TheBlackMini/upsy-desky/pcb_v2/upsy-desky.kicad_pcb

## KiCad design pcb_v2/upsy-desky.kicad_pcb (2024-06-04)

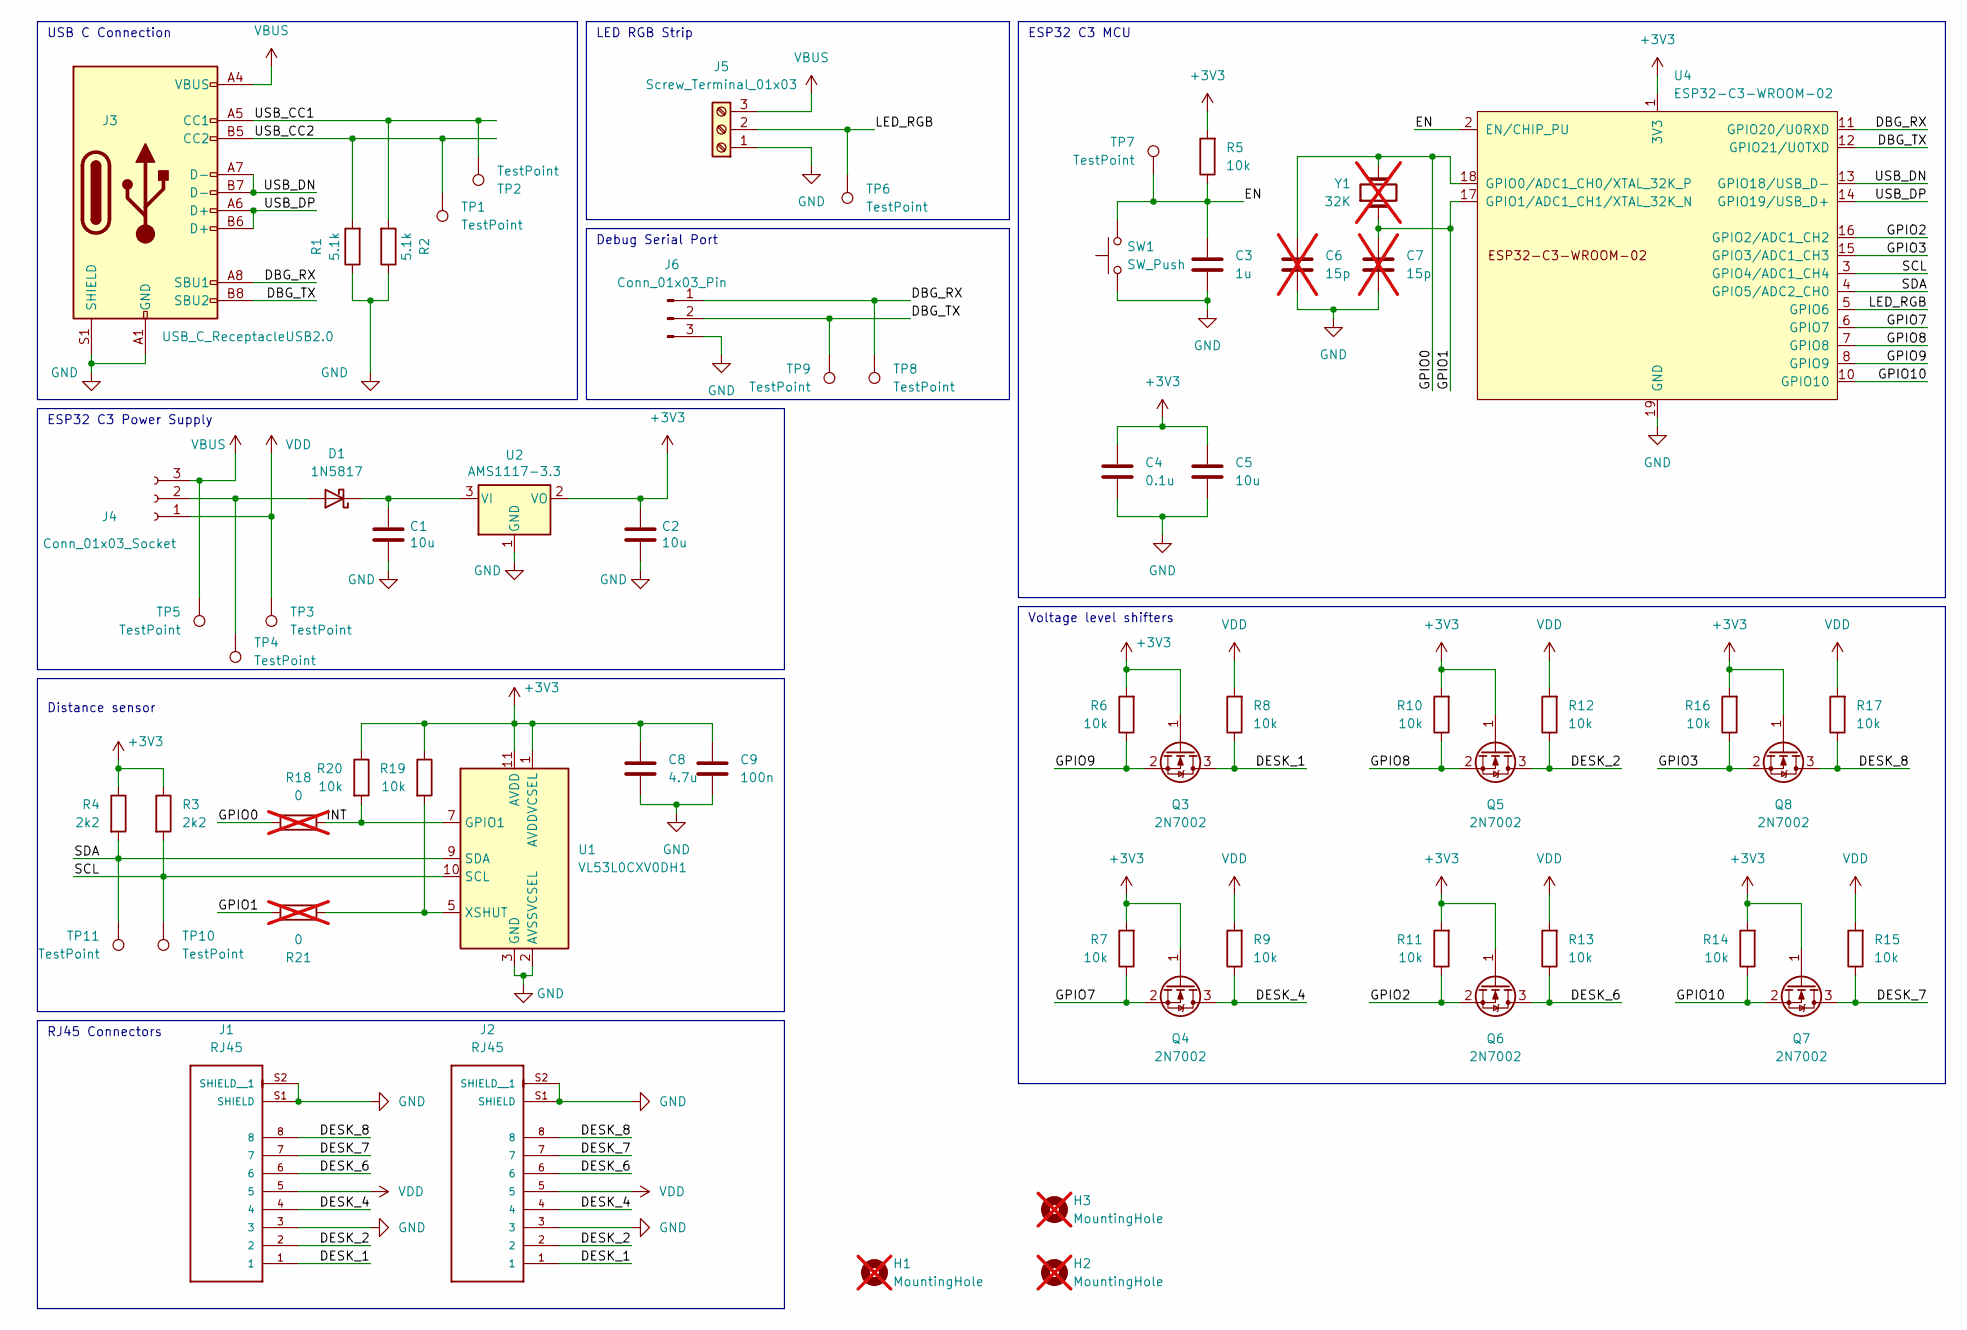
[picture p1: schematic upsy-desky.kicad_sch, (Risky) Upsy Desky]

Parts:
C1, C2, C5: 10u; C_0402_1005Metric; MPN GRM155R60J106ME05J; LCSC C15525
C3: 1u; C_0402_1005Metric; MPN 0402W105K100HI; LCSC C52923
C4: 0.1u; C_0402_1005Metric; MPN 0402B104K160HI; LCSC C1525
C6, C7: 15p; C_0402_1005Metric; MPN TCC0402COG150J500AT; not fitted
C8: 4.7u; C_0402_1005Metric; MPN CL05A475MQ5NRNC; DigiKey 1276-1056-2-ND
C9: 100n; C_0402_1005Metric; MPN CC0402KRX7R6BB104; DigiKey 311-1345-2-ND
D1: 1N5817; D_SOD-323; MPN B5817WS-TP; LCSC C191023
H1, H2, H3: MountingHole; MountingHole_2.2mm_M2_Pad; not fitted
J1, J2: RJ45; RJ45_Amphenol_54602-x08_Horizontal; PARTREV 00; LCSC C708595
J3: USB_C_ReceptacleUSB2.0; USB_C_Receptacle_Palconn_UTC16-G; MPN TYPE-C-31-M-12; LCSC C165948
J4: Conn_01x03_Socket; FanPinHeader_1x03_P2.54mm_Vertical; MPN 0022272031; DigiKey WM4112-ND
J5: Screw_Terminal_01x03; TerminalBlock_Altech_AK300-3_P5.00mm; MPN 30-003; DigiKey 1920-30.003-ND
J6: Conn_01x03_Pin; JST_EH_B3B-EH-A_1x03_P2.50mm_Vertical; MPN B3B-EH-A; DigiKey 455-B3B-EH-A-ND
Q3, Q4, Q5, Q6, Q7, Q8: 2N7002; SOT-23; MPN 2N7002; LCSC C8545
R1, R2: 5.1k; R_0402_1005Metric; MPN CR0402JC5K1S01; LCSC C25905
R3, R4: 2k2; R_0402_1005Metric; MPN RC0402FR-072K2L; DigiKey 311-2.20KLRTR-ND
R5, R6, R7, R8, R9, R10, R11, R12, R13, R14, R15, R16, R17: 10k; R_0402_1005Metric; MPN RC0402JR-1310KL; LCSC C25744
R18, R21: 0; R_0402_1005Metric; not fitted
R19, R20: 10k; R_0402_1005Metric; MPN RC0402JR-1310KL; DigiKey 13-RC0402JR-1310KLTR-ND
SW1: SW_Push; SW_Push_1P1T_NO_CK_KMR2; MPN KMR223GLFG; DigiKey 401-1428-2-ND
TP1, TP2, TP3, TP4, TP5, TP6, TP7, TP8, TP9, TP10, TP11: TestPoint; TestPoint_Pad_D1.0mm
U1: VL53L0CXV0DH1; ST_VL53L1x; MPN VL53L0CXV0DH/1; DigiKey 497-16538-2-ND
U2: AMS1117-3.3; SOT-223-3_TabPin2; MPN AMS1117-3.3; LCSC C6186
U4: ESP32-C3-WROOM-02; MPN ESP32-C3-WROOM-02-N4; DigiKey 1965-ESP32-C3-WROOM-02-N4TR-ND
Y1: 32K; Crystal_SMD_2012-2Pin_2.0x1.2mm; MPN 9HT11-32-768KDZF-T; DigiKey 887-1425-2-ND; not fitted

Connections:
+3V3: C2.1, C4.1, C5.1, C8.1, C9.1, Q3.1 (G), Q4.1 (G), Q5.1 (G), Q6.1 (G), Q7.1 (G), Q8.1 (G), R3.1, R4.1, R5.2, R6.2, R7.2, R10.2, R11.2, R14.2, R16.2, R19.1, R20.1, U1.1 (AVDDVCSEL), U1.11 (AVDD), U2.2 (VO), U4.1 (3V3)
/DBG_RX: J3.A8 (SBU1), J6.1, TP8.1, U4.11 (GPIO20/U0RXD)
/DBG_TX: J3.B8 (SBU2), J6.2, TP9.1, U4.12 (GPIO21/U0TXD)
/DESK_1: J1.1, J2.1, Q3.3 (D), R8.1
/DESK_2: J1.2, J2.2, Q5.3 (D), R12.1
/DESK_4: J1.4, J2.4, Q4.3 (D), R9.1
/DESK_6: J1.6, J2.6, Q6.3 (D), R13.1
/DESK_7: J1.7, J2.7, Q7.3 (D), R15.1
/DESK_8: J1.8, J2.8, Q8.3 (D), R17.1
/EN: C3.1, R5.1, SW1.2, TP7.1, U4.2 (EN/CHIP_PU)
/GPIO0: C6.1, R18.2, U4.18 (GPIO0/ADC1_CH0/XTAL_32K_P), Y1.2
/GPIO1: C7.1, R21.2, U4.17 (GPIO1/ADC1_CH1/XTAL_32K_N), Y1.1
/GPIO2: Q6.2 (S), R11.1, U4.16 (GPIO2/ADC1_CH2)
/GPIO3: Q8.2 (S), R16.1, U4.15 (GPIO3/ADC1_CH3)
/GPIO7: Q4.2 (S), R7.1, U4.6 (GPIO7)
/GPIO8: Q5.2 (S), R10.1, U4.7 (GPIO8)
/GPIO9: Q3.2 (S), R6.1, U4.8 (GPIO9)
/GPIO10: Q7.2 (S), R14.1, U4.10 (GPIO10)
/INT: R18.1, R20.2, U1.7 (GPIO1)
/LED_RGB: J5.2, TP6.1, U4.5 (GPIO6)
/SCL: R3.2, TP10.1, U1.10 (SCL), U4.3 (GPIO4/ADC1_CH4)
/SDA: R4.2, TP11.1, U1.9 (SDA), U4.4 (GPIO5/ADC2_CH0)
/USB_CC1: J3.A5 (CC1), R2.2, TP2.1
/USB_CC2: J3.B5 (CC2), R1.2, TP1.1
/USB_DN: J3.A7 (D-), J3.B7 (D-), U4.13 (GPIO18/USB_D-)
/USB_DP: J3.A6 (D+), J3.B6 (D+), U4.14 (GPIO19/USB_D+)
GND: C1.2, C2.2, C3.2, C4.2, C5.2, C6.2, C7.2, C8.2, C9.2, J1.3, J1.S1 (SHIELD), J1.S2 (SHIELD__1), J2.3, J2.S1 (SHIELD), J2.S2 (SHIELD__1), J3.A1 (GND), J3.A12 (GND), J3.B1 (GND), J3.B12 (GND), J3.S1 (SHIELD), J5.1, J6.3, R1.1, R2.1, SW1.1, U1.2 (AVSSVCSEL), U1.3 (GND), U1.4 (GND), U1.6 (GND), U1.12 (GND), U2.1 (GND), U4.9 (GND), U4.19 (GND)
unnamed: D1.2 (A), J4.2, TP4.1
unnamed: C1.1, D1.1 (K), U2.3 (VI)
unnamed: R19.2, R21.1, U1.5 (XSHUT)
VBUS: J3.A4 (VBUS), J3.A9 (VBUS), J3.B4 (VBUS), J3.B9 (VBUS), J4.3, J5.3, TP5.1
VDD: J1.5, J2.5, J4.1, R8.2, R9.2, R12.2, R13.2, R15.2, R17.2, TP3.1

Notes on the sheet:
ESP32 C3 MCU
Debug Serial Port
RJ45 Connectors
USB C Connection
LED RGB Strip
Distance sensor
Voltage level shifters
ESP32 C3 Power Supply

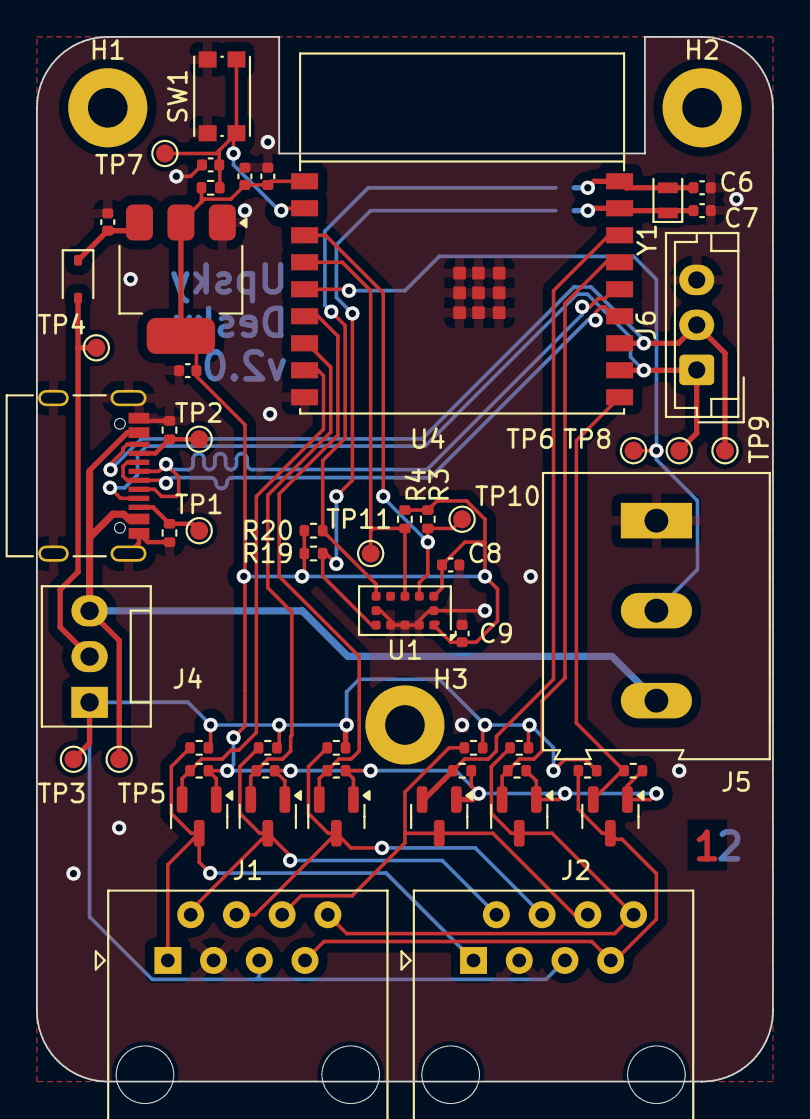
[picture p2: board upsy-desky.kicad_pcb from above]

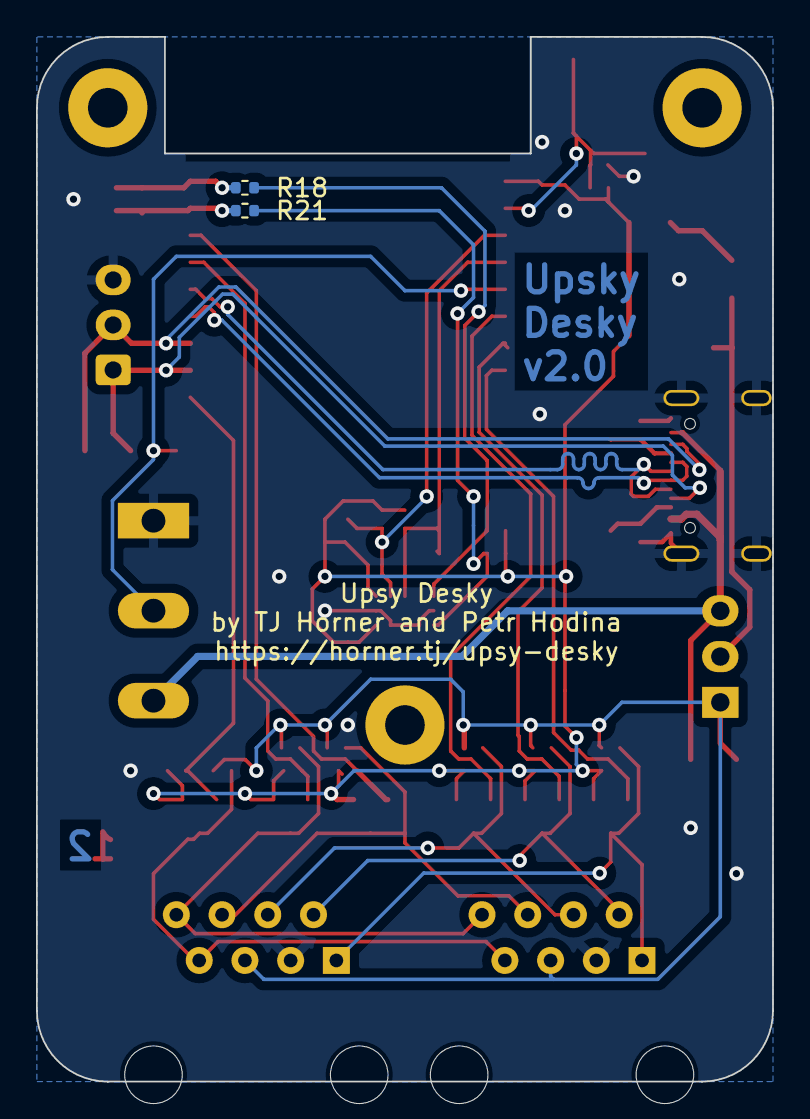
[picture p3: board upsy-desky.kicad_pcb from below]

Board: 2 copper layers, 40.9 x 58.0 mm, 62 parts (2 on the bottom side), 32 nets.
